jrowe88/ecoport-bridge/docs/images/cta2045-connector-pinout-ashb.png

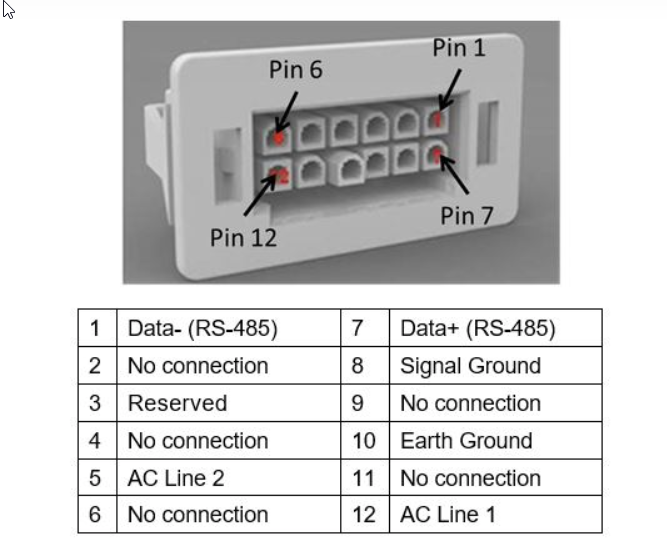
docs/images/cta2045-connector-pinout-ashb.png
