jrowe88/ecoport-bridge/hardware/enclosure/step/ecoport-bridge-rev-a-lid.step

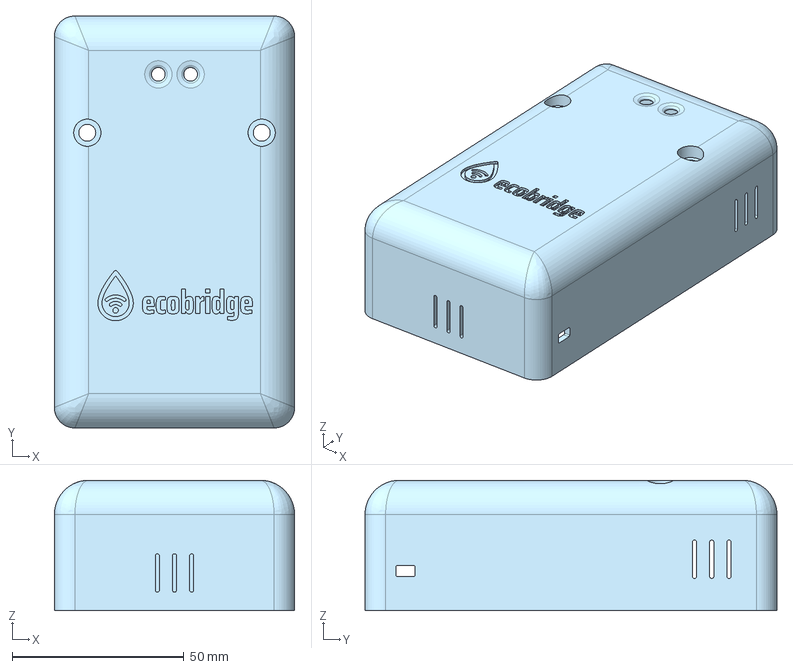
[picture p6: CAD file, 2026-10-21]
hardware/enclosure/step/ecoport-bridge-rev-a-lid.step
70.0 x 120.0 x 38.0 mm
