jrowe88/ecoport-bridge/hardware/rev-a/3d/ecoport-bridge-v1.step

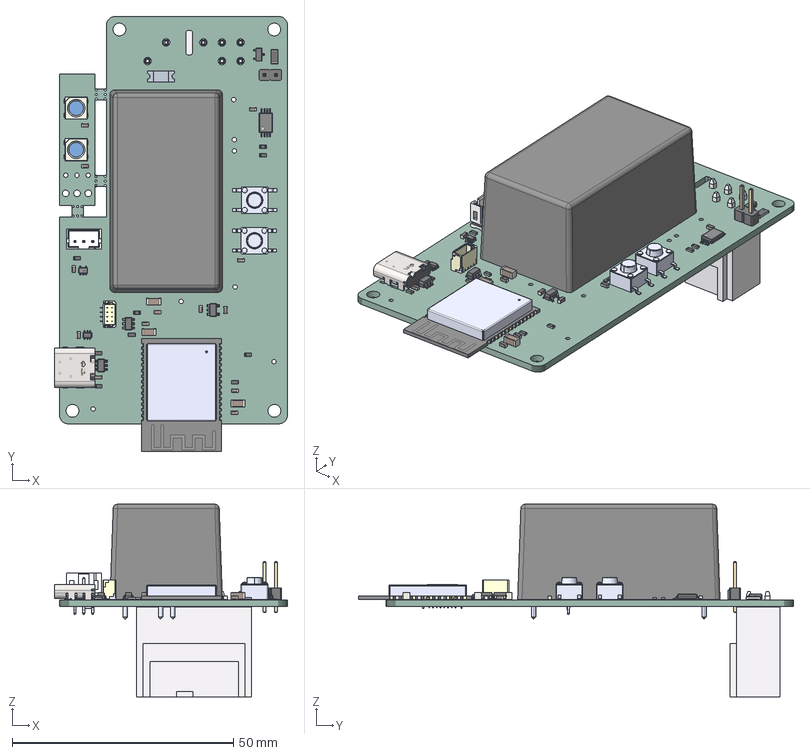
[picture p7: CAD file, 2026-10-21]
hardware/rev-a/3d/ecoport-bridge-v1.step
52.6 x 98.3 x 43.5 mm
R_0603_1608Metric x 9
SOT-23
C_0603_1608Metric x 13
pin x 3
USC-C-SMD_USB4085-GF-A
SOT-23-5
SOT-363_SC-70-6
R_1206_3216Metric
SC-70-5_L2.1-W1.3-H1.0-LS2.1-P0.65
LED_SK6812_PLCC4_50x50mm_P32mm x 2
SOT-23-6 x 2
AF2-2410
零件34
PinHeader_1x02_P254mm_Vertical
BM04B-SRSS-TBT(LF)(SN)
C_1206_3216Metric x 3
ESP32-C6-WROOM-1-N8
CUI_DEVICES_TS04-66-50-BK-260-SMT x 2
IRM-05-5
ecoport-bridge-v1_PCB
