jrowe88/ecoport-bridge/hardware/enclosure/step/ecoport-bridge-rev-a-bottom-plate.step

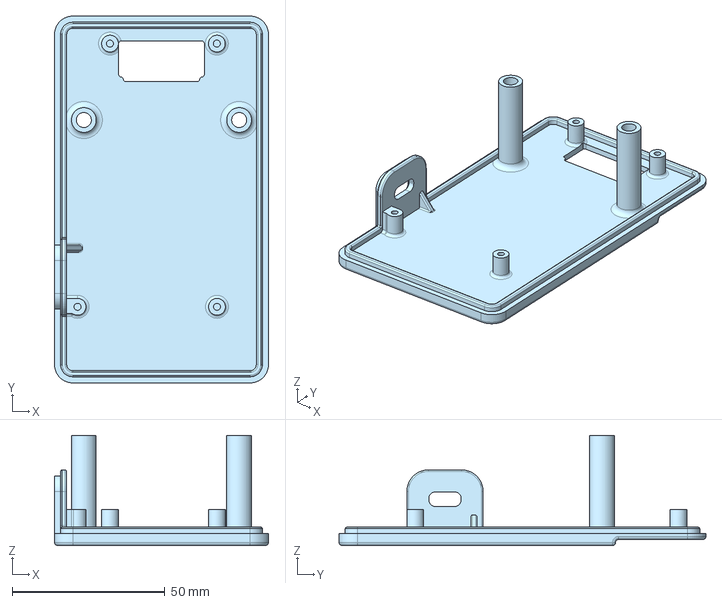
[picture p8: CAD file, 2026-10-21]
hardware/enclosure/step/ecoport-bridge-rev-a-bottom-plate.step
70.0 x 120.0 x 36.0 mm
