jrowe88/ecoport-bridge/docs/getting-started.md

# Getting Started

## Prerequisites

- Python 3.11+
- Rust via [rustup](https://rustup.rs/), plus `ldproxy` and `espflash`
  (for firmware work; see [`firmware/README.md`](../firmware/README.md))
- An isolated USB/RS-485 adapter (for talking to real hardware)
- EPRI's UCM simulator app/software (optional but recommended — lets you
  develop and test the protocol implementation without appliance hardware)

## Python environment

```bash
cd python
python -m venv .venv
. .venv/Scripts/activate   # Windows PowerShell: .venv\Scripts\Activate.ps1
pip install -e ".[dev]"
pytest
```

## Firmware environment

```bash
cd firmware/cta2045 && cargo test        # protocol crate, runs on your PC
cd ../ucm && cargo run --release         # build, flash and monitor the ESP32-C6
```

See [`firmware/README.md`](../firmware/README.md) for first-time setup.

## Developing in VS Code

Open the repository root. VS Code offers the recommended extensions from
`.vscode/extensions.json` (rust-analyzer, C# Dev Kit, Azure Functions, Azurite,
Static Web Apps, Bicep, PowerShell). `EcoPort.slnx` at the root holds every .NET
project, so C# Dev Kit's Test Explorer shows the cloud and web tests together.

Tasks (**Terminal > Run Task**):

| Task | What it does |
|---|---|
| Start local stack | Azurite, Device API on `0.0.0.0:7071`, User API on 7072, Blazor on 5000, then the SWA emulator on 4280. Open http://localhost:4280 and sign in with role `bench` |
| Test all | Rust host tests (`cta2045`, `bridge-core`), then `dotnet test EcoPort.slnx` |
| Firmware: build (devkit) / flash + monitor | `cargo build` / `cargo run --release` in `firmware/ucm` |

First-time setup for the local stack (settings files, registering a device in
Azurite, the firewall rule for the devkit) is in
[`cloud/README.md`](../cloud/README.md). To debug, run the stack, then use
**Attach: Device API** or **Attach: User API** in Run and Debug.

## Tools

Command-line helpers live in `tools/`:

- `sniff.py` — passively capture and log raw CTA-2045 traffic. It never
  writes to the serial port:

  ```powershell
  python tools\sniff.py --port COM3 --scenario idle-baseline --duration 300
  ```

  Each run creates a timestamped capture directory under `captures\rinnai\`
  containing `capture.bin` (the original byte stream), `capture.jsonl`
  (timestamped hex/base64 receive events), and a `notes.md` operator log.
- `decode.py` — decode a saved capture (RX frames, ACK/NAKs, and any
  `transmit.jsonl` TX log) into a labelled timeline:

  ```powershell
  python tools\decode.py captures\rinnai\<capture-dir>
  ```
- `ucm.py` — **transmits.** Acts as a minimal CTA-2045 UCM: answers the
  appliance with link ACK/NAKs and, with `--probe`, starts the handshake and
  sends read-only queries (see "First active session" below).
- `query.py` — send a one-off query to a connected appliance (not yet implemented)
- `interactive.py` — interactive REPL for exploring the protocol (not yet implemented)
- `packet_capture.py` — capture helper shared by the above

Before using the sniffer on the heater, follow the
[Rinnai control-panel passive-capture plan](rinnai-control-panel-capture-plan.md).
It provides a repeatable manual test matrix for idle, mode transitions
(including Heat Pump Only if available), setpoint changes, and heating
transitions — all without sending any CTA-2045 command.

## First active session (`ucm.py`)

`ucm.py` refuses to run without `--transmit`. It only ever sends:

| When | Bytes | Meaning |
|---|---|---|
| Any packet received | `06 00` / `15 xx` | Link ACK / NAK, ~60 ms later |
| Appliance asks max payload | `08 03 00 02 19 07 ..` | "We accept up to 256 bytes" (Level 2 minimum) |
| `--probe` start | `08 01/02/03 00 00 ..` | Message Type Supported Queries |
| `--probe` start + every 60 s | `08 01 00 02 0E 01 ..` | Outside comm status: good |
| `--probe` start + every 60 s | `08 01 00 02 12 00 ..` | Query operational state |
| `--probe` start | `08 02 00 02 01 01 ..` | Intermediate DR GetInformation |
| `--probe` start | `08 03 00 02 18 00 ..` | Ask the heater's max payload |
| `--probe` start + every 60 s | `08 02 00 02 06 00 ..` | Commodity Read (tank capacity / present energy take, Wh) |
| `--survey` only | `08 04` / `09 01–0C` supported queries, Intermediate `01 02`, `02 00`, `03 00–04`, `06 00`, `06 01`, `0A 00 00`, `0B 00 00/01` | One pass of every spec-defined read (Get forms only; their Set counterparts use a different opcode or a longer payload) |

No shed, load-up, setpoint, price, or other control commands.

```powershell
python tools\ucm.py --port COM4 --scenario first-ucm-probe --transmit --probe --duration 300
```

Look for `RX 06 00 ... link ACK` after each TX — that is the heater
answering. Output goes to a capture directory with `capture.bin` (RX only),
`transmit.jsonl` (our TX), and `session.log`. The FTDI adapter does not echo
our TX. If yours does, add `--echo-filter`.

If every TX gets "no ACK": check D+/D- polarity first, then whether the
adapter needs `--rts-tx` (adapters without automatic direction control).
`--port loop://` runs a hardware-free smoke test.

### Marking operator actions and reading the timeline

While `ucm.py` runs, type a short note in its window and press Enter, e.g.
`setpoint 120 -> 125` or `element mode ON`. It is logged as a timestamped
`MARK` line. Afterwards:

```powershell
python tools\ucm_timeline.py captures\rinnai\<capture-dir>
```

This writes `timeline.csv` (every opstate/Commodity Read sample and mark) and
prints only the rows where something changed, with the energy-take slope (Wh/h)
since the previous change. Small take jitter (18 Wh steps) is suppressed.

Setpoint calibration: right after each panel change, type `sp <new temp>`
(e.g. `sp 118`). The timeline tool then also writes `calibration.csv`, mapping
setpoint to total energy storage capacity, using the first Commodity Read at
least one poll after each mark.

### Control commands (writes to the appliance)

With `--allow-control`, lines starting with `/` are sent as CTA-2045 Basic DR
commands. Durations are in minutes (default 7.5, max 120). The spec encodes
them as 2·n² seconds, so values are rounded, e.g. 7.5, 30 or 60.

| Type | Sends | Expected effect |
|---|---|---|
| `/shed [min]` | `01 dd` Shed | Opstate 4 Idle Curtailed / 2 Running Curtailed |
| `/cpe [min]` | `0A dd` Critical Peak Event | Deeper curtailment |
| `/ge [min]` | `0B dd` Grid Emergency | Deepest curtailment |
| `/loadup [min]` | `17 dd` Load Up | Opstate 3/6 Heightened; heats now |
| `/power <0-100>` | `06 pp` Request for Power Level | Limit average power |
| `/end` | `02 00` End Shed / Run Normal | Cancel the event |

Each command is followed by an opstate query. An App ACK (`03 xx`) means only
"received and supported"; the opstate shows whether the heater complied. An
App NAK (`04 rr`) gives a reason. **End Shed is sent automatically on exit**
(including Ctrl+C) whenever a command was sent. The event duration and the
panel's own override are further fallbacks.

## Safety note

The CTA-2045 AC-form-factor connector can carry mains power in addition to
RS-485. Only pins 1 (D-), 7 (D+), and 8 (GND) are used for this project;
leave all other pins unconnected and use an isolated RS-485 adapter.
