jrowe88/ecoport-bridge/hardware/enclosure/print-settings.md

# Print Settings

TODO: recommended slicer settings (material, layer height, infill, supports)
for the EcoPort Bridge enclosure.
