jrowe88/ecoport-bridge/hardware/rev-a/assembly.md

# Rev A Assembly Notes

TODO: assembly steps, isolation testing procedure, and safety checks for
Rev A of the EcoPort Bridge hardware.
