jrowe88/ecoport-bridge/hardware/rev-a/pcb/ecoport-bridge-v1-pcb.pdf

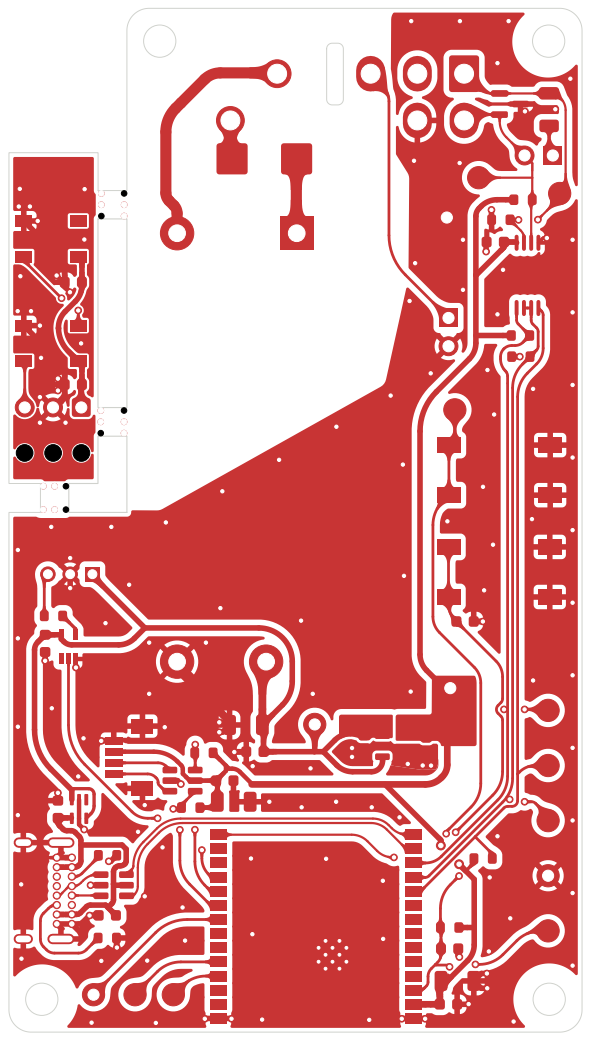
[picture p9: page 1]

Size: A4 | Rev:
KiCad E.D.A. 10.0.7 | Id: 1/6

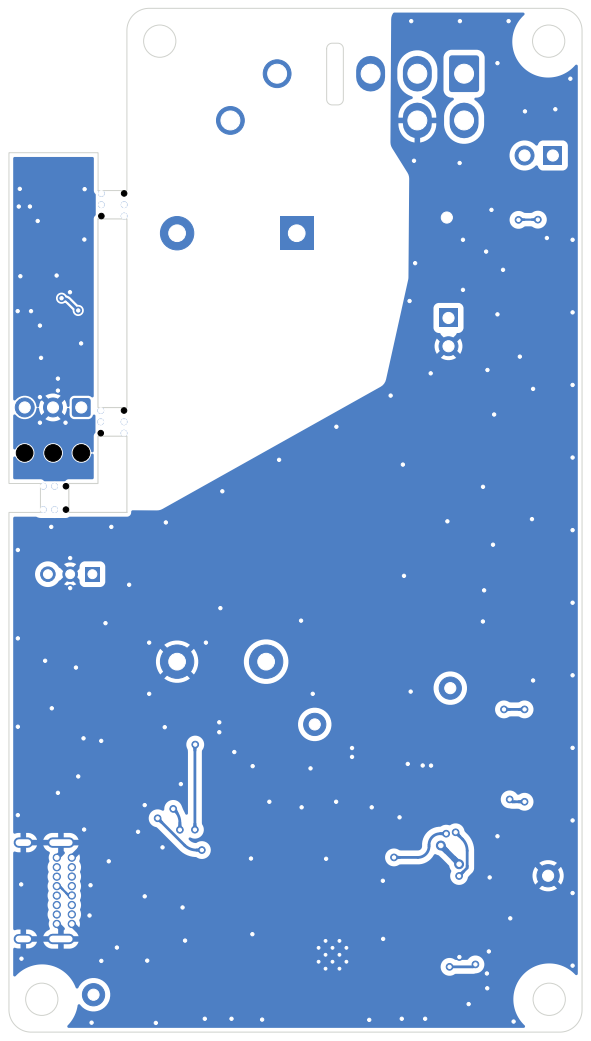
[picture p10: page 2]

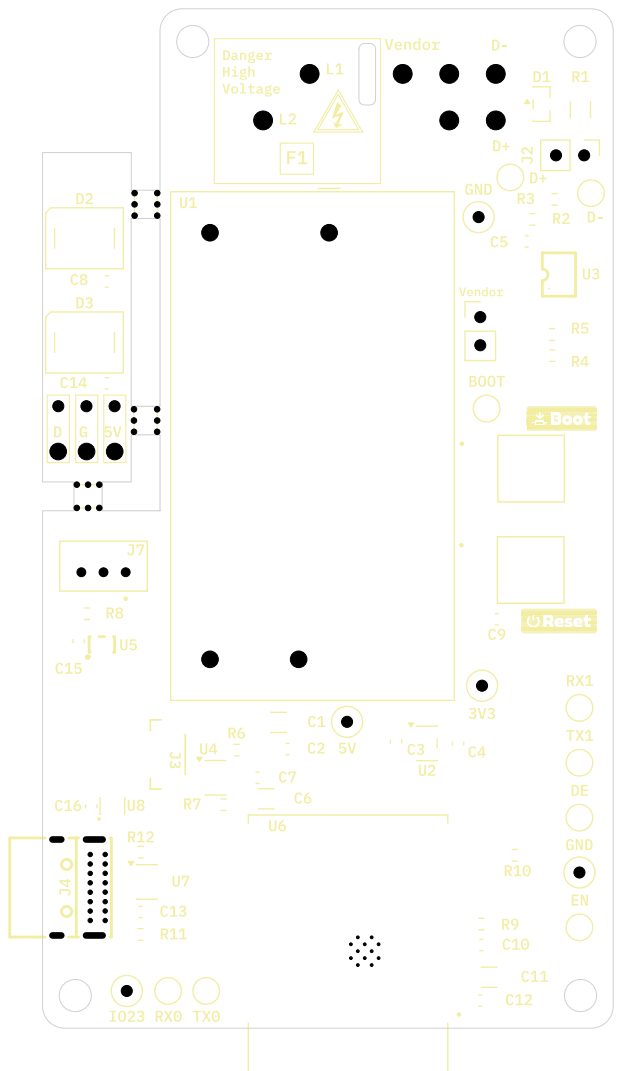
[picture p11: page 3]

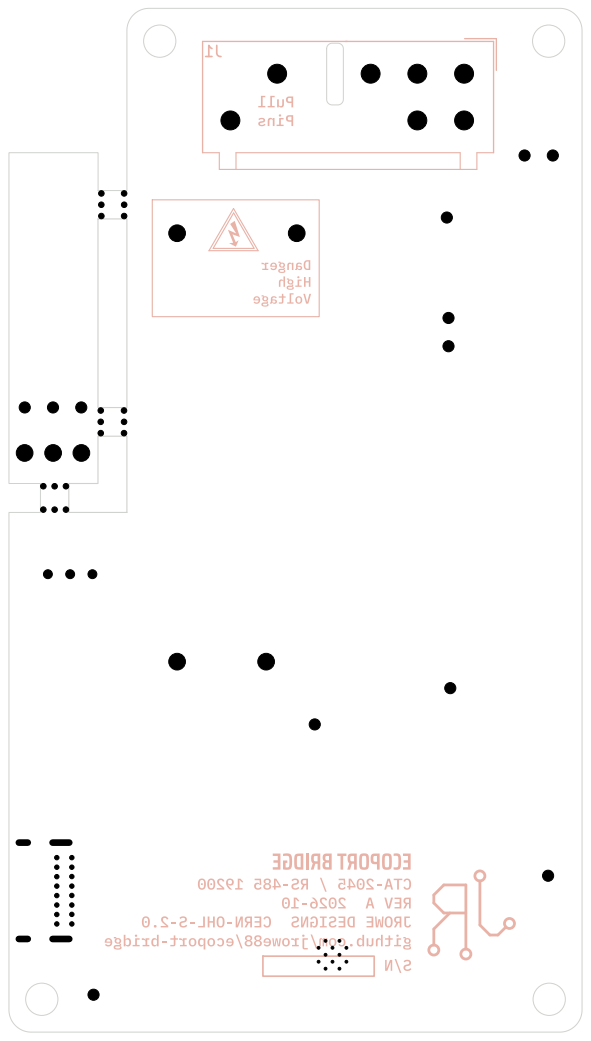
[picture p12: page 4]

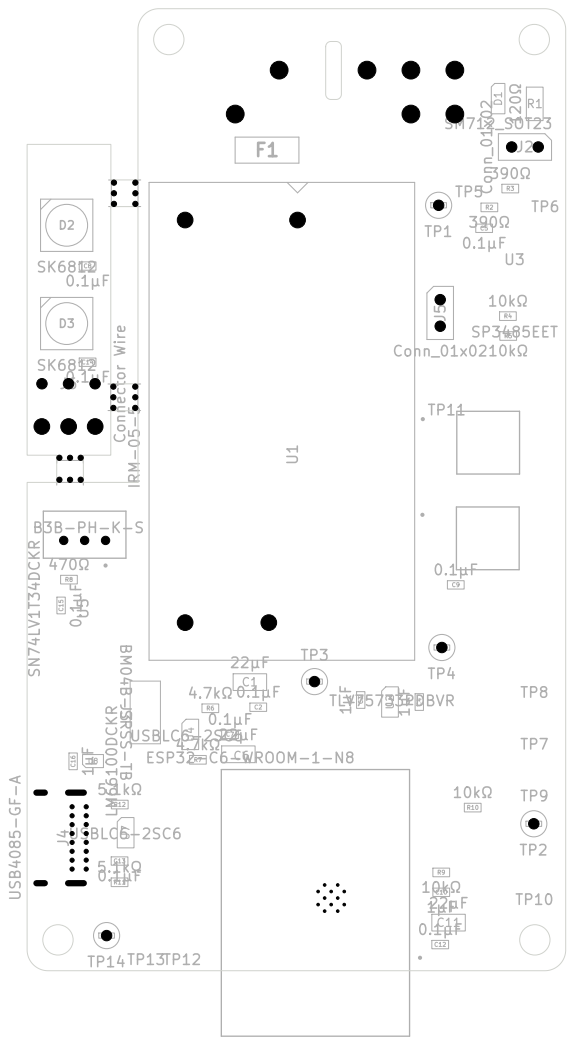
[picture p13: page 5]

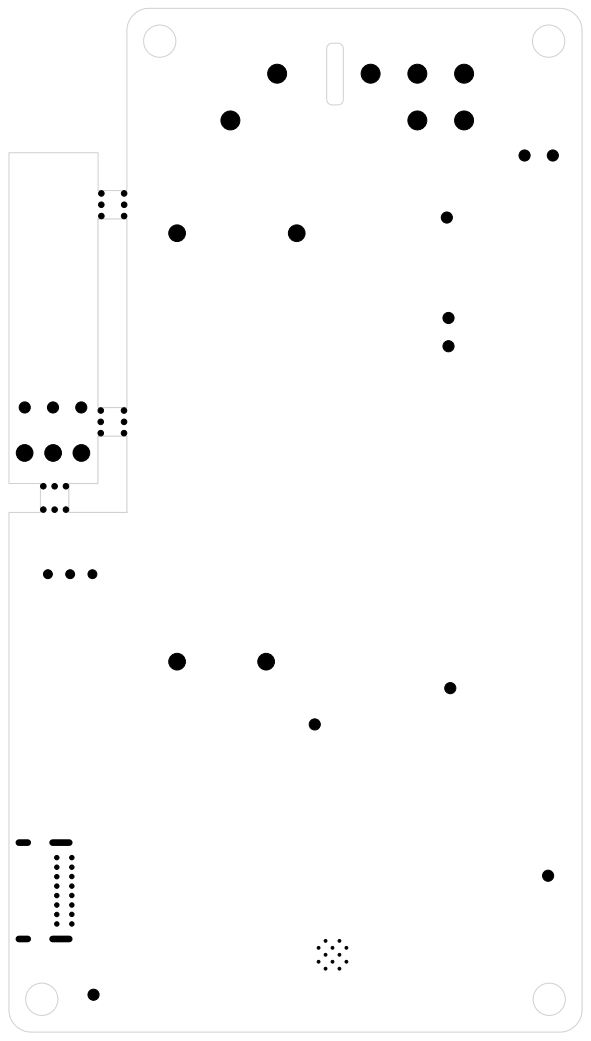
[picture p14: page 6]
