jrowe88/ecoport-bridge/firmware/src/main.cpp

#include "cta2045/cta2045.h"
#include "transport/transport.h"
#include "appliance/rinnai/rinnai.h"

// EcoPort Bridge firmware entry point.
// TODO: initialize transport (isolated RS-485 UART), CTA-2045 core,
// appliance layer, network stack, and integrations (MQTT/Matter).

void setup() {
  // TODO
}

void loop() {
  // TODO
}
