jrowe88/ecoport-bridge/tools/interactive.py

#!/usr/bin/env python3
"""Interactive REPL for exploring the CTA-2045 protocol against a live adapter.

TODO: implement using ecoport.cta2045 + ecoport.transport.
"""

if __name__ == "__main__":
    raise NotImplementedError("tools/interactive.py: not yet implemented")
