jrowe88/ecoport-bridge/tools/query.py

#!/usr/bin/env python3
"""Send a one-off query to a connected CTA-2045 appliance.

TODO: implement using ecoport.cta2045 + ecoport.appliances.
"""

if __name__ == "__main__":
    raise NotImplementedError("tools/query.py: not yet implemented")
