jrowe88/ecoport-bridge/(commit log)

2026-09-28 Initial project scaffold for EcoPort Bridge
    Sets up the repository structure for a CTA-2045 (EcoPort) bridge project,
    targeting a Rinnai REHP65 heat pump water heater initially. Includes docs,
    hardware/firmware/python layout, tooling stubs, and capture/test scaffolding
    per the agreed project plan.
    [bom.csv]
2026-09-28 Capture salient planning details from source conversation into docs
    Pulls the technical content from the original ChatGPT planning thread/PDF
    into the repo's documentation:
    - docs/references.md (new): EPRI simulator/library, python-cta2045, ANSI
    preview, EcoPort certified product DB, OpenADR, and connector part
    numbers (420B2V12FL0 vs 420C2PM12FL0/420CP-T-2 clarification)
    - docs/hardware.md: corrected connector/crimp guidance, AC-form-factor
    safety procedure for identifying pins, bring-up hardware platform
    recommendation (Pi/Linux first, MCU for production)
    - docs/protocol.md: Basic/Intermediate DR message type bytes, EPRI sample
    command checklist, Rinnai capability matrix table
    -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
2026-09-28 Add confirmed full 12-pin CTA-2045 connector pinout
    Independently corroborates the RS-485/ground pins (1, 7, 8) previously
    inferred from the EPRI simulator cable, and adds the full pin map from a
    published diagram (ASHB / Ken Wacks' Perspectives article):
    - Pin 3: reserved
    - Pin 5: AC Line 2
    - Pin 10: Earth Ground (distinct from pin 8 Signal Ground)
    - Pin 12: AC Line 1
    - All others: no connection
    Updates:
    - docs/hardware.md: full 12-pin table, sharpened safety warning now that
    the AC line pins are specifically identified (5, 12)
    - docs/protocol.md: Confirmed section updated with the full pin map
    - docs/references.md: adds the ASHB source
    - docs/images/cta2045-connector-pinout-ashb.png: r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
2026-09-29 Document power supply findings: no 5V rail on CTA-2045 connector
    Pins 5/12 (AC Line 1/2) are raw mains voltage, not a regulated logic-level
    supply. Since this project only connects pins 1/7/8, the bridge board must
    be powered independently (USB for prototype; wall-wart or, later, an
    isolated AC-DC module for a self-contained production unit).
    - docs/hardware.md: new Power section, updated shopping list
    - docs/protocol.md: Confirmed section notes the lack of a DC supply pin
2026-10-01 Add passive CTA-2045 capture tooling and panel test plan
    Add a receive-only serial sniffer and a reusable capture writer that preserve raw bytes, timestamped receive events, and operator notes. Document a safe Rinnai control-panel capture matrix for baseline, mode, setpoint, and heating transitions without transmitting CTA-2045 commands. Fix the Python package readme configuration so the documented editable development install works.\n\nCo-authored-by: Copilot <223556219+Copilot@users.noreply.github.com>
    [packet_capture.py, sniff.py]
2026-10-03 Record first passive Rinnai DR capture
    Preserve the DR-disabled and DR-enabled idle captures and document the measured result: enabling DR produced a repeating 32.4-second sequence of four frame forms, while the comparable DR-disabled capture received no bytes. Keep the frame meanings explicitly unconfirmed until additional passive captures and EPRI comparison validate them.\n\nCo-authored-by: Copilot <223556219+Copilot@users.noreply.github.com>
2026-10-03 Decode Rinnai DR traffic as CTA-2045-B UCM discovery
    Add DR off->on transition capture. Implement Fletcher checksum and frame splitting (verified on all captured frames and spec examples), make tools/decode.py functional, and document decoded frames, timing, and the 15-minute stop hypothesis.
2026-10-03 Add minimal CTA-2045 UCM responder (tools/ucm.py)
    Answers the appliance with link ACK/NAK and a max-payload response; with --probe starts the handshake and sends only read-only/status messages (supported queries, outside-comm-good, opstate query, GetInformation). Requires --transmit. Adds streaming parser with ACK/NAK recognition and echo filtering, TX logging, decode.py timeline with TX, and simulated-SGD tests.
2026-10-03 First active UCM session: decode GetInformation, delay max-payload reply
    Heater answers link ACK, opstate (Running Normal) and GetInformation (version A, vendor 0x0C22, type 0x0003 HPWH). Max payload response NAKed (15 07); default app reply delay now 1.0 s, add --app-reply-delay and --max-payload-indicator nak.
2026-10-04 UCM: add setpoint/temperature reads, dedupe max-payload replies
    0x07 indicator did not stop the ~22 s discovery cycle; it looks like a periodic link check. Probe now also queries SGD max payload, GetSetPoint and GetPresentTemperature (2-byte read-only forms); keepalive reads temperature. Repeated queries supersede unsent replies (fixes 15 07 at startup).
    [ucm.py]
2026-10-04 Fix echo filter eating heater replies; add Commodity Read to probe; survey notes
    [ucm.py]
2026-10-04 Hold requests during heater discovery rounds; commodity-1 capture notes
2026-10-04 Heating-cycle capture: commodity take tracks hot water usage and recovery
    [commodity.csv]
2026-10-04 Operator MARK notes in ucm.py; ucm_timeline.py state-change summary
    [commodity.csv, timeline.csv]
2026-10-04 Panel-modes capture: setpoint, heat source and vacation signatures
    [timeline.csv]
2026-10-04 Guarded Basic DR control commands (--allow-control) and setpoint calibration extraction
2026-10-16 Add KiCad board v1 (ecoport-bridge-v1) and custom library
    Schematic, PCB, design rules (mains creepage/clearance) and the project's
    custom symbols, footprints and 3D models. Ignore KiCad local history,
    backups, lock files and per-user .kicad_prl.
2026-10-16 Initial board design DRC all passes
2026-10-17 Added fuse
2026-10-17 added usb power and reorganized assets
2026-10-17 Pull J1 pin 9, fill in MPNs, 1A fuse, rev-a release assets
    - Remove J1 pin 9 (NC) from symbol, footprint and board: its floating pad
    sat 4.4 mm from F1 and 1.6 mm from pin 8, short of 5.5 mm creepage.
    Pull list is now pins 4, 6, 9, 10, 11.
    - F1 to SF-2410SP100W-2 (1 A time-lag) for inrush margin; footprint fields
    and assembly notes updated to match.
    - J3 is the top-entry BM04B-SRSS-TB to match its footprint.
    - Add missing MPN/Manufacturer for U6, J7, J3, D2/D3 (value typo SKC6812 ->
    SK6812) and TP14, and include TP14 in the BOM.
    - hardware/rev-a: populated bom.csv, DigiKey upload file for 6 boards,
    interactive BOM, board STEP for the enclosure (3d/), images/ for visual
    assets, an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
2026-10-20 Rework board outline and mouse-bite tabs; ignore reference PDFs
    - New outline and LED-strip tab positions; lower tab sized to fit the
    3-hole mouse bites.
    - docs/*.pdf ignored: copyrighted CTA-2045 / EPRI references stay local.
2026-10-20 Rounded traces, board edge, fixed diode traces
2026-10-21 Refresh rev-a STEP and PCB PDF after graphics update
    The STEP and PCB plot were exported before the marking/logo silkscreen
    changes in 6c66706. Gerbers were already current (re-plotted and compared;
    only object order differs).
2026-10-21 Refresh rev-a interactive BOM after graphics update
2026-10-21 Add enclosure README and rev-A lid/bottom-plate STEP exports
    Links the public Onshape document pinned to the Rev A version and keeps STEP
    copies of the two printed parts in the repo as the durable, CAD-neutral source.
2026-10-21 Describe the #8-32 enclosure mounting screws
2026-10-21 Add rev-A enclosure renders; show exploded view in README
    Renders go in hardware/rev-a/images. The main README shows the exploded view
    under the intro; the enclosure README shows front/back/side.
2026-10-26 Switch firmware to Rust on ESP-IDF; update architecture plan
    - Replace the PlatformIO stub with firmware/cta2045 (host-testable framing,
    checksum and stream parser ported from Python, with capture replay tests)
    and firmware/ucm (ESP32-C6 app: Wi-Fi, status LED, receive-only RS-485
    monitor on the rev-A pins).
    - Architecture: RAM-first record buffer with flash spill after ~15 min of
    failed uploads, commands piggybacked on upload responses (no 20 s poll),
    Blazor WASM + MudBlazor PWA dashboard, ESP BLE Provisioning app, Bicep
    instead of Terraform, cost table.
    - Add firmware CI workflow.
2026-10-26 Add M1 bench plan and device API v1 contract
2026-10-26 Add bridge-core: records, wire format, request signing
2026-10-26 Add sequence allocator, recorder, RAM buffer, upload schedule, replay heater
2026-10-26 Add cloud solution, contracts and device request signing
2026-10-26 ucm: board/heater features, replay sampling, signed uploads
2026-10-26 Add device records endpoint with table ingest and fake device
2026-10-26 Add Blazor/MudBlazor dashboard
    Blazor WebAssembly PWA (net10.0, MudBlazor 9.11) consuming the User API:
    a device list and a device page with power, stored energy, opstate,
    last seen, connectivity and simulated chips, and 24 h power and
    stored-energy charts, refreshed every 30 s. API failures render an
    alert instead of throwing. SWA config requires the bench role for
    everything except the login page and /.auth/*. bUnit tests use a fake
    IEcoPortApi and a fake TimeProvider.
2026-10-26 Add user API for device list, state and telemetry
2026-10-26 infra: use a separate Azure CLI profile for EcoPort
    The personal-account login fails in the shared default profile (work tenant).
    Scripts now default AZURE_CONFIG_DIR to ~/.azure-ecoport; README documents
    the device-code login.
2026-10-26 Add VS Code workspace setup and a root EcoPort.slnx
    Recommended extensions, rust-analyzer linked projects, tasks to start the
    local stack and run all tests, attach/debug configs. Only these four
    .vscode files are tracked; personal settings stay ignored.
